messcheg/WaterStorageControler/images/sonar-in-watertube.png

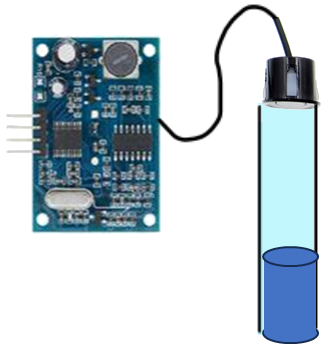
images/sonar-in-watertube.png
