messcheg/WaterStorageControler/images/2-channel-solid-state-relay.bmp

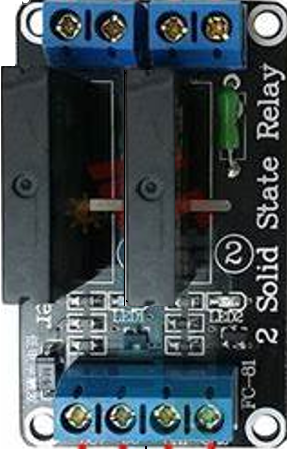
images/2-channel-solid-state-relay.bmp
