messcheg/WaterStorageControler/(commit log)

2023-02-05 renamed the file to let it work with the Arduino IDE
2023-07-11 Made fix for termometer errors. Added time correction.
    [WaterStorageControler.ino]
2023-07-21 Updated lower and upper boudaaries for switching
2024-10-27 Added circuit design
2025-08-02 Changed switch level. Freed mempory to be able to update libraries.
